YashP007/home-sensor-platform/hardware/enclosure/README.md

# Enclosure Files

STL files for the 3D-printable enclosure will be uploaded here after fit validation against the assembled PCB.

Planned files:

- `back_plate.stl` — wall-mounted piece with female dovetail slot
- `main_box.stl` — PCB housing with male dovetail rail and cable cutouts
- `back_plate.f3d` — Fusion 360 source
- `main_box.f3d` — Fusion 360 source

See [`docs/enclosure-design.md`](../../docs/enclosure-design.md) for design rationale and print orientation notes.
