YashP007/home-sensor-platform/firmware/dev_spotifyAPI/art/Doechii - Nosebleeds_300.jpg

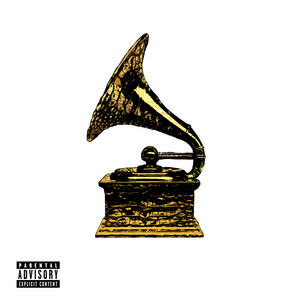
firmware/dev_spotifyAPI/art/Doechii - Nosebleeds_300.jpg
