YashP007/home-sensor-platform/firmware/dev_spotifyAPI/art/Noah Kahan - The Great Divide_300.jpg

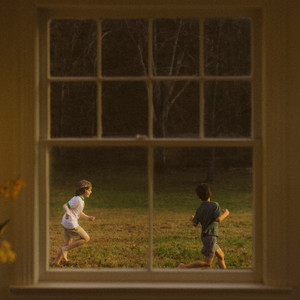
firmware/dev_spotifyAPI/art/Noah Kahan - The Great Divide_300.jpg
