YashP007/home-sensor-platform/firmware/dev_spotifyAPI/art/Russ_ Bibi Bourelly - SANTIAGO_300.jpg

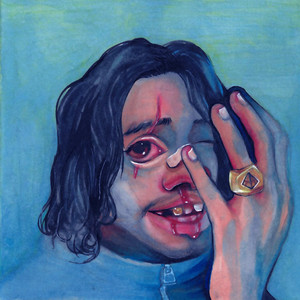
firmware/dev_spotifyAPI/art/Russ_ Bibi Bourelly - SANTIAGO_300.jpg
