YashP007/home-sensor-platform/hardware/pcb_images/pcb_layout_bottom.png

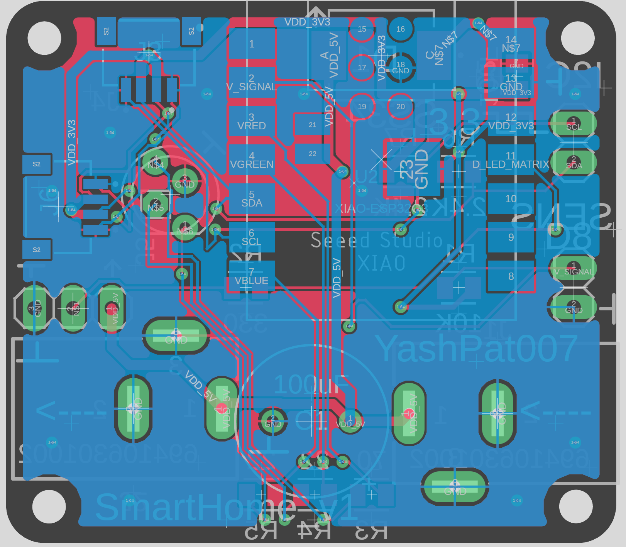
hardware/pcb_images/pcb_layout_bottom.png
