YashP007/home-sensor-platform/hardware/pcb_images/pcb_layout_top.png

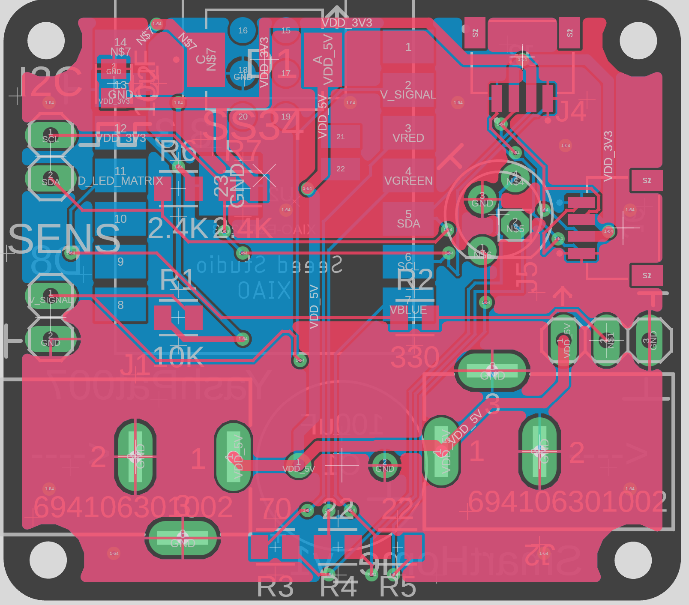
hardware/pcb_images/pcb_layout_top.png
