YashP007/home-sensor-platform/hardware/pcb_images/pcb_render_iso.png

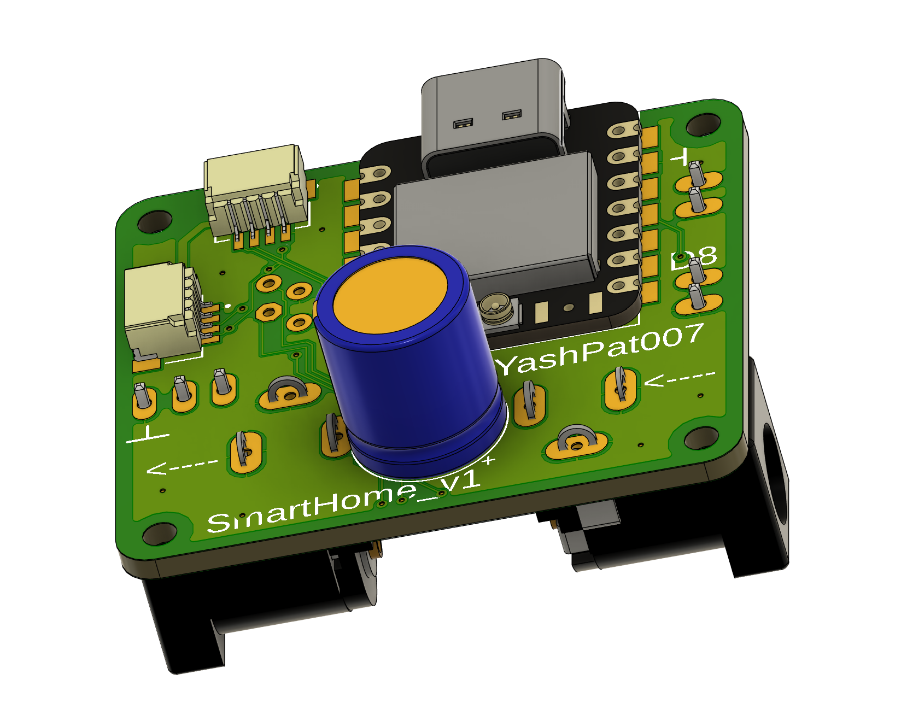
hardware/pcb_images/pcb_render_iso.png
