YashP007/home-sensor-platform/hardware/schematic.pdf

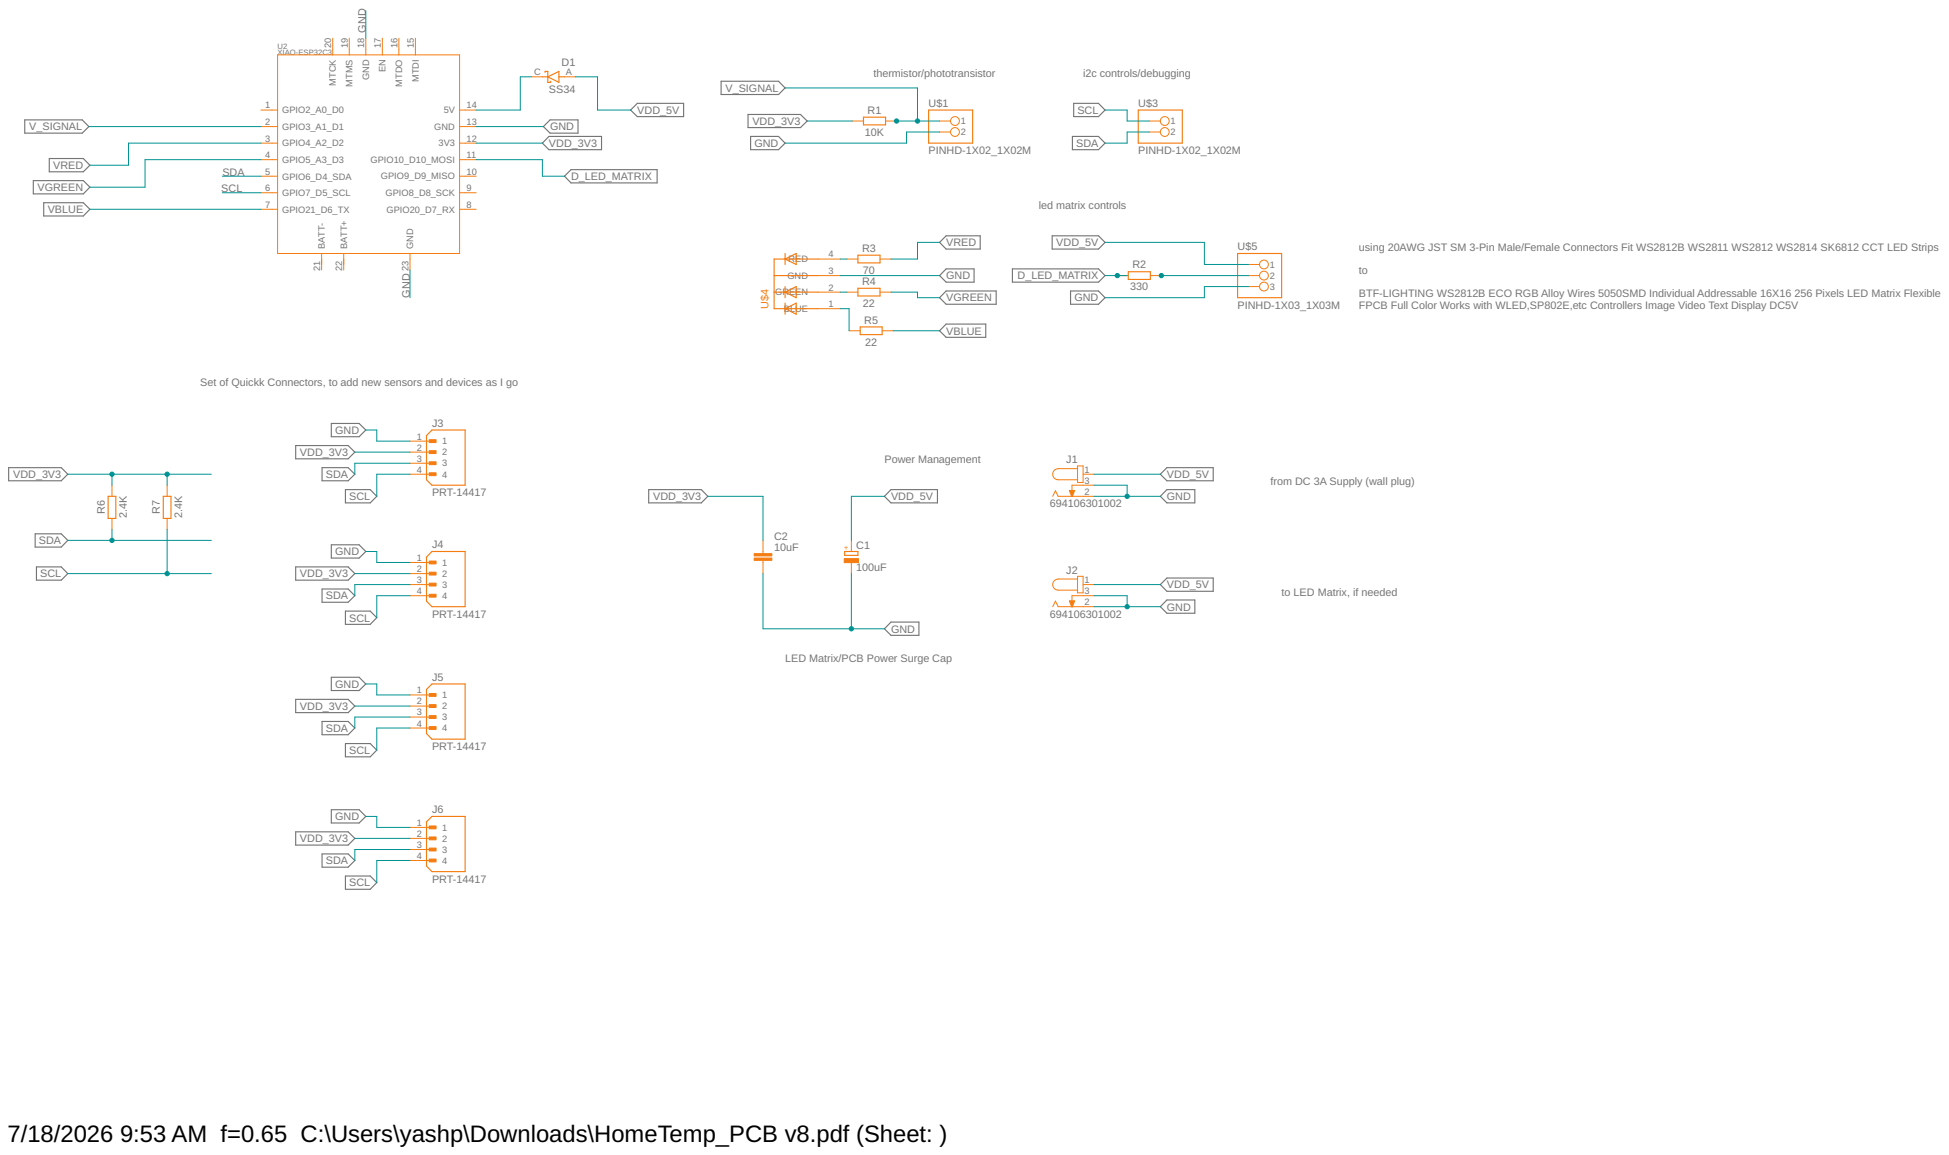
[picture p9: page 1]

using 20AWG JST SM 3-Pin Male/Female Connectors Fit WS2812B WS2811 WS2812 WS2814 SK6812 CCT LED Strips

toBTF-LIGHTING WS2812B ECO RGB Alloy Wires 5050SMD Individual Addressable 16X16 256 Pixels LED Matrix Flexible FPCB Full Color Works with WLED,SP802E,etc Controllers Image Video Text Display DC5V

Set of Quickk Connectors, to add new sensors and devices as I go

from DC 3A Supply (wall plug)

SDA | 4

to LED Matrix, if needed

LED Matrix/PCB Power Surge Cap

7/18/2026 9:53 AM f=0.65 C:\Users\yashp\Downloads\HomeTemp_PCB v8.pdf (Sheet: )
