YashP007/home-sensor-platform/(commit log)

2026-07-18 Fix image paths in README.md
    Updated image paths in README for PCB renders.
2026-07-18 Revise README for clarity and project details
    Updated the motivation section to clarify the project's goals and address the limitations of one-off breadboard prototypes. Revised project tiers for clarity and corrected details about the future Spotify display.
2026-07-18 restructuring files
    [BOM.csv]
2026-08-05 Revise HVAC state inference logic to improve accuracy and add humidity/pressure publishing
2026-08-05 Enhance outdoor temperature integration with Open-Meteo support and improve data handling
